DrOnkel/ReHabJr/Dinamometr_Schematics.jpg

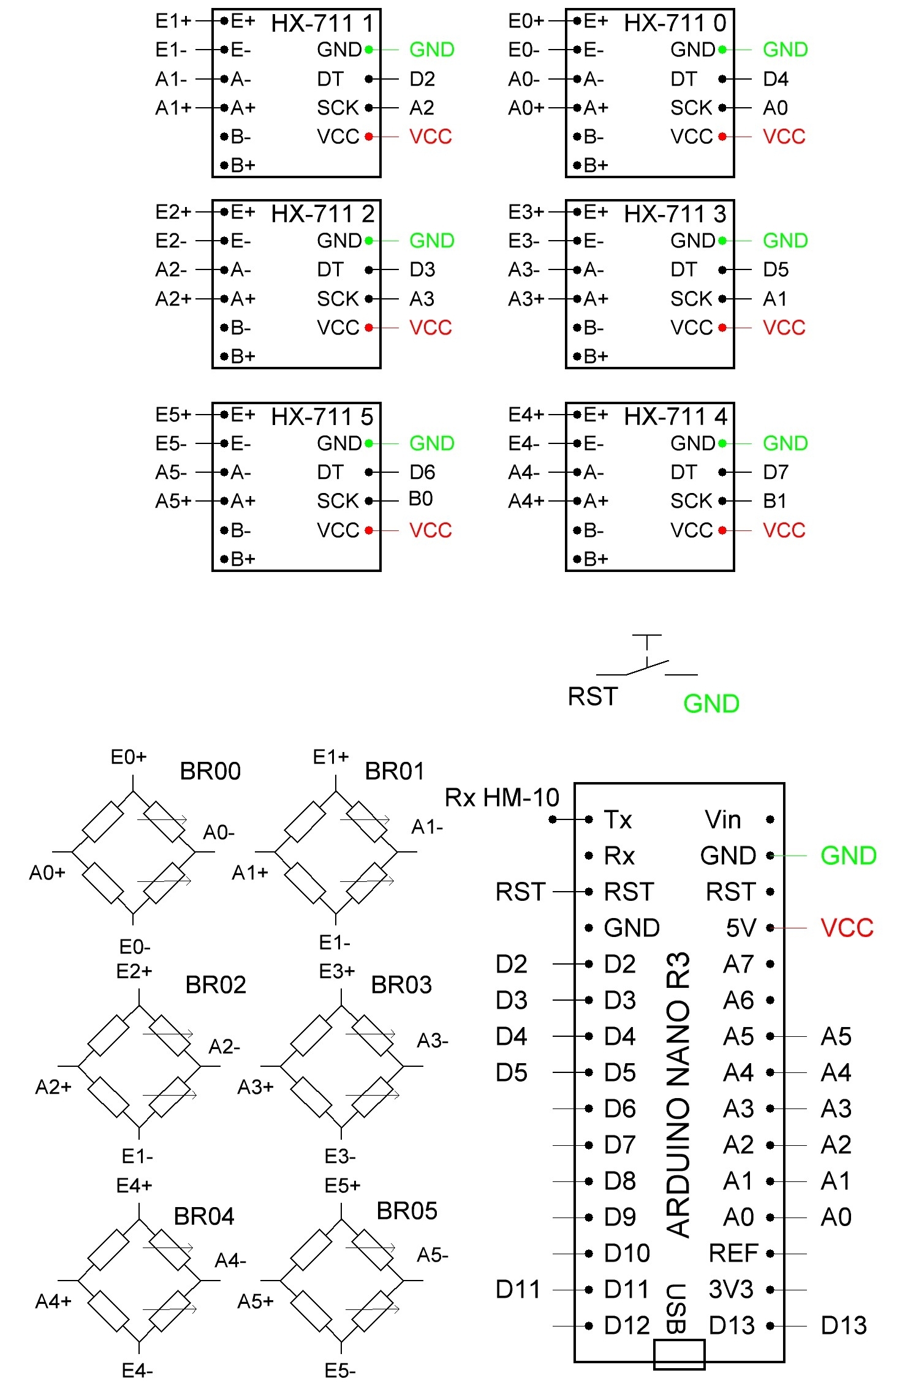
Dinamometr_Schematics.jpg
