DrOnkel/ReHabJr/ServoMotorsSchematics.jpg

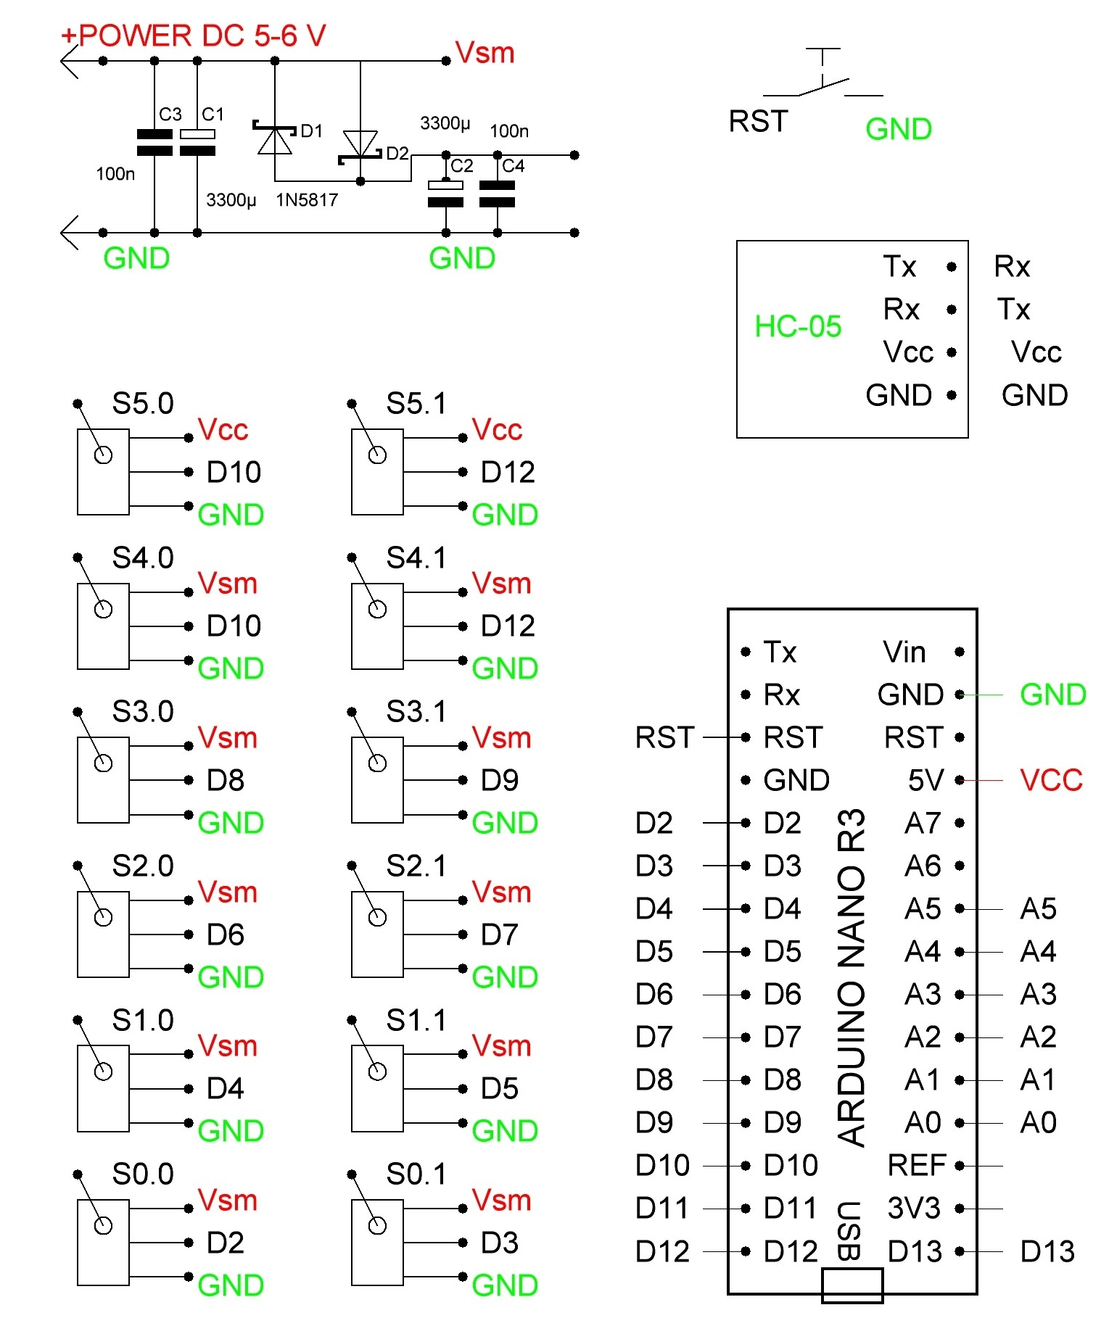
ServoMotorsSchematics.jpg
