DrOnkel/ReHabJr/Boxing19L.stl

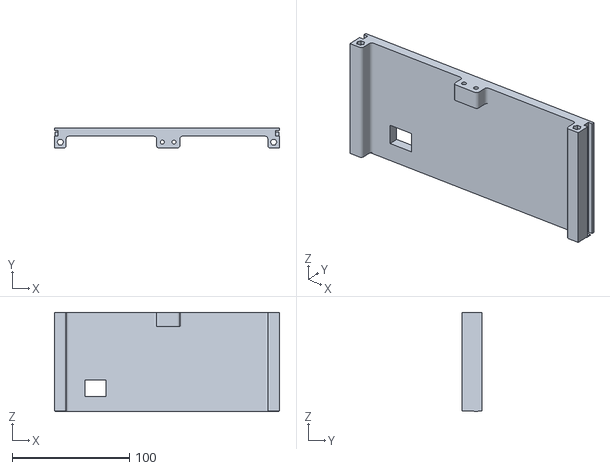
[picture p3: CAD file, 2019-08-07]
Boxing19L.stl
192.0 x 17.0 x 84.8
