DrOnkel/ReHabJr/DinHolder10.stl

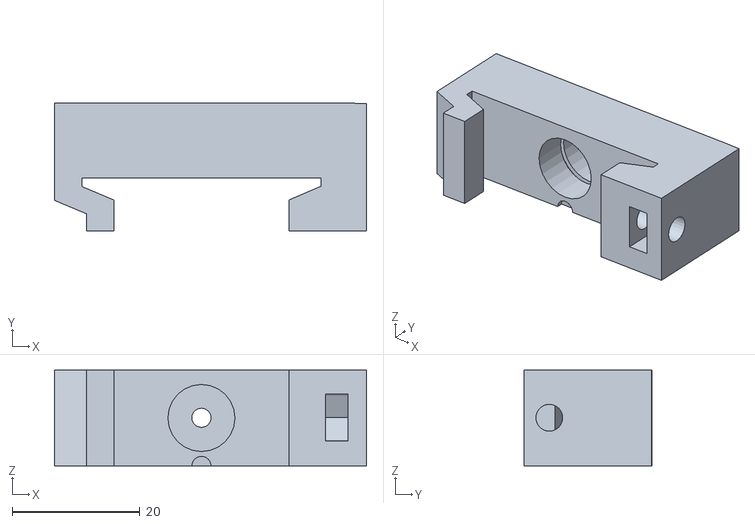
[picture p4: CAD file, 2019-08-07]
DinHolder10.stl
48.8 x 20.0 x 15.0
