DrOnkel/ReHabJr/Boxing05B.stl

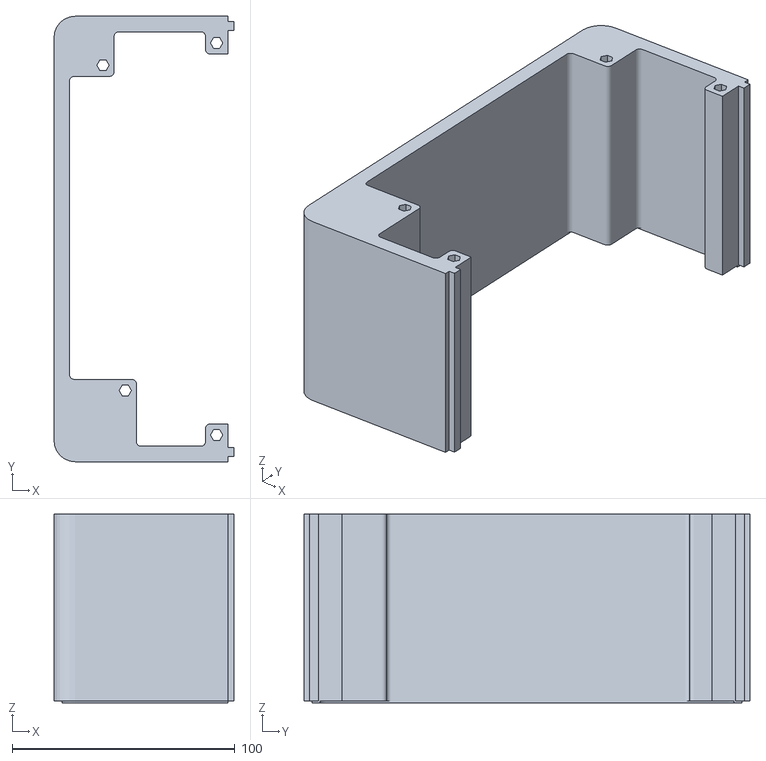
[picture p5: CAD file, 2019-08-07]
Boxing05B.stl
80.8 x 200.0 x 84.8
