DrOnkel/ReHabJr/Boxing05F.stl

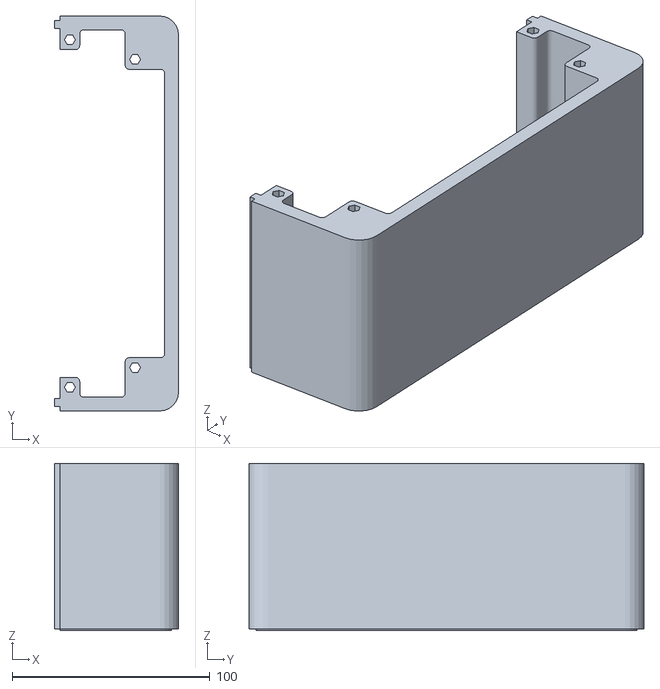
[picture p6: CAD file, 2019-08-07]
Boxing05F.stl
62.8 x 200.0 x 84.8
