DrOnkel/ReHabJr/FlateF3d0.stl

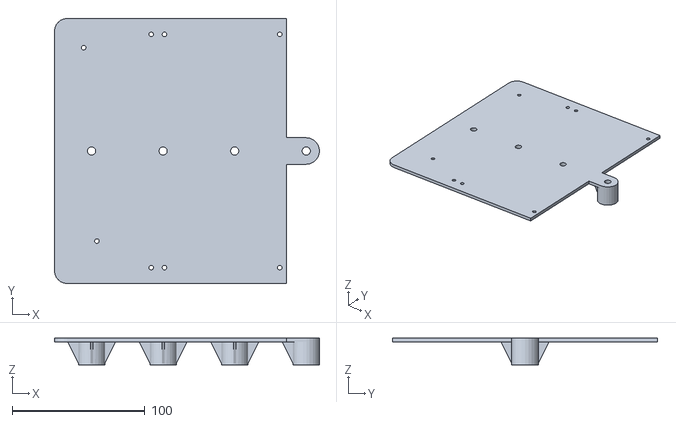
[picture p7: CAD file, 2019-08-07]
FlateF3d0.stl
200.0 x 200.0 x 20.0
