DrOnkel/ReHabJr/Forward00.stl

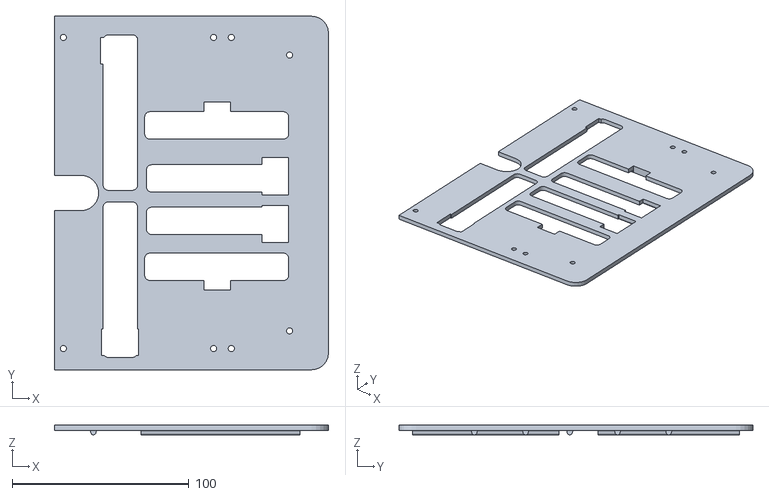
[picture p8: CAD file, 2019-08-07]
Forward00.stl
155.0 x 200.0 x 5.50
