DrOnkel/ReHabJr/(list of files, cad)

Other CAD files:
Boxing19R.stl
