DrOnkel/ReHabJr/(commit log)

2019-08-01 Add files via upload
    Schematics
2019-08-01 Add files via upload
    Servo Motor Part Schematics
